jaggerzhong/microduck-hub-board/docs/BOM.md

# 元器件清单

## 一、板上元器件（一共 6 个）

| 位号 | 器件 | 规格 | 数量 | 替代 / 采购备注 |
| --- | --- | --- | ---: | --- |
| CN2–CN5 | AMP2.0 3P 直插母座 | A2007WV-3P，脚距 2.0 mm，插件 | 4 | 只要脚距 2.0、3P 的直插母座都行；买散件一般 50 个一拍 |
| CN1 | 2P 直插座 | 脚距 2.5 mm（EH2.5），插件 | 1 | XH2.54 也能插（脚距偏差 0.02 mm）；或者干脆把电池线直接焊进这两个孔，不装座 |
| C1 | 电解电容 | 1000 µF / 16 V（或以上），径向，脚距 3.5 mm，Ø8 × 8~9 mm | 1 | 2S 电池最高 8.4 V，16 V 耐压够；优先挑矮的，板下净空只有约 5 mm。25 V 同尺寸的也可以，别买 5 mm 脚距的 |

成本参考：母座和电容加起来不到 10 元（按最小包装买会剩很多）。

## 二、打样参数

| 项 | 值 |
| --- | --- |
| 文件 | hardware/gerber/Microduck-HUB-RevC-Gerber.zip |
| 尺寸 | 23 × 34 mm |
| 层数 | 2 |
| 板厚 | **1.0 mm** |
| 铜厚 | 1 oz（够用）/ 2 oz（更稳，不加价时选它） |
| 表面处理 | 有铅喷锡、无铅喷锡、OSP 都可以 |
| 阻焊 / 字符 | 绿色 / 白色 |
| 过孔处理 | 盖油（板上无过孔，怎么选都不影响） |
| 最小孔径 | 0.3 mm 档即含全部孔（板上有 1.0 mm 和 2.2 mm） |
| 数量 | 5 片 |

嘉立创网页版样板价约 30 元；新用户免费打样券能把板费做到 0 元，但券**只能在下单小助手（Windows）或手机 APP 里核销**，网页版用不了。

## 三、装机需要但不在板上的东西

| 物料 | 规格 | 用途 |
| --- | --- | --- |
| M2 螺丝 | M2 × 12 左右（长度按下方公式算） | 把板子固定在髋舵机外壳顶上 |
| M2 尼龙柱 / 垫块 | 高 6.3 mm（板厚 1.0 mm 时） | 板子必须抬离舵机安装面，见 [ASSEMBLY.md](ASSEMBLY.md) |
| M2 尼龙垫圈 | Ø2.2 内孔 | 螺丝头压到板上铜皮时做绝缘 |

螺丝长度 = 板厚 + 垫高 + 咬入 4~5 mm。板厚 1.0、垫高 6.3 时约 **M2 × 12**。
换 1.6 mm 板厚的话，垫高要相应减 0.6 mm（保持板顶面高度不变），螺丝长度不变。
