jaggerzhong/microduck-hub-board/hardware/pads.csv

pad | net | x_mm | y_mm | drill_mm | pad_mm
CN2.GND | GND | -4.055 | 7.0 | 1.0 | 1.5
CN2.VBAT | VBAT | -4.055 | 9.0 | 1.0 | 1.5
CN2.DATA | DATA | -4.055 | 11.0 | 1.0 | 1.5
CN3.GND | GND | 4.055 | 11.0 | 1.0 | 1.5
CN3.VBAT | VBAT | 4.055 | 9.0 | 1.0 | 1.5
CN3.DATA | DATA | 4.055 | 7.0 | 1.0 | 1.5
CN4.GND | GND | 4.055 | -7.0 | 1.0 | 1.5
CN4.VBAT | VBAT | 4.055 | -9.0 | 1.0 | 1.5
CN4.DATA | DATA | 4.055 | -11.0 | 1.0 | 1.5
CN5.GND | GND | -4.055 | -11.0 | 1.0 | 1.5
CN5.VBAT | VBAT | -4.055 | -9.0 | 1.0 | 1.5
CN5.DATA | DATA | -4.055 | -7.0 | 1.0 | 1.5
C1.+ | VBAT | -1.75006 | 0.0 | 1.0 | 1.6
C1.- | GND | 1.75006 | 0.0 | 1.0 | 1.6
CN1.GND | GND | -1.25006 | -13.4 | 1.0 | 1.5
CN1.VBAT | VBAT | 1.25006 | -13.4 | 1.0 | 1.5
