jaggerzhong/microduck-hub-board/(commit log)

2026-11-06 Microduck HUB 分线板 RevC：Gerber、KiCad、生成脚本与文档
    [Microduck-HUB-RevC-B_Cu.gbl, Microduck-HUB-RevC-B_Mask.gbs, Microduck-HUB-RevC-B_Silkscreen.gbo, Microduck-HUB-RevC-Edge_Cuts.gko, Microduck-HUB-RevC-F_Cu.gtl, Microduck-HUB-RevC-F_Mask.gts, Microduck-HUB-RevC-F_Silkscreen.gto, Microduck-HUB-RevC.drl]
2026-11-06 Add English README and bilingual language switch
